pokelondon/mobile-sled/Photos/IMG_3144.jpg

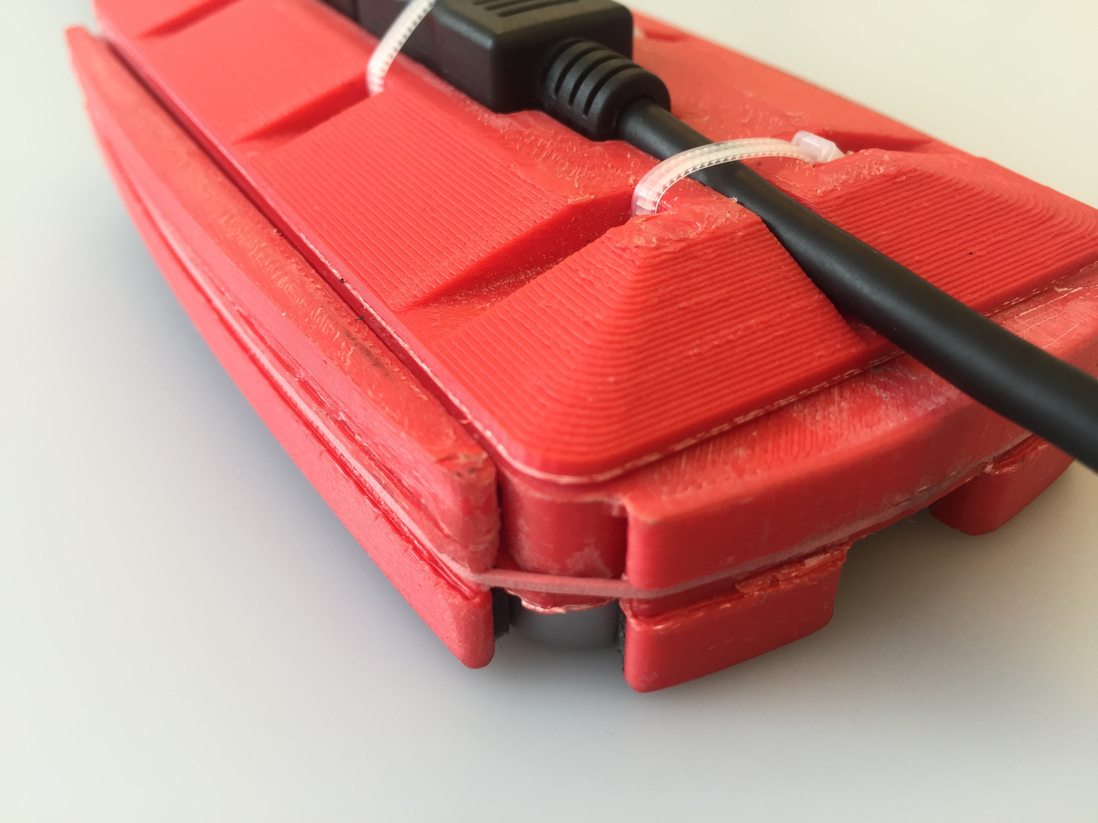
Photos/IMG_3144.jpg
