pokelondon/mobile-sled/Photos/IMG_3135.jpg

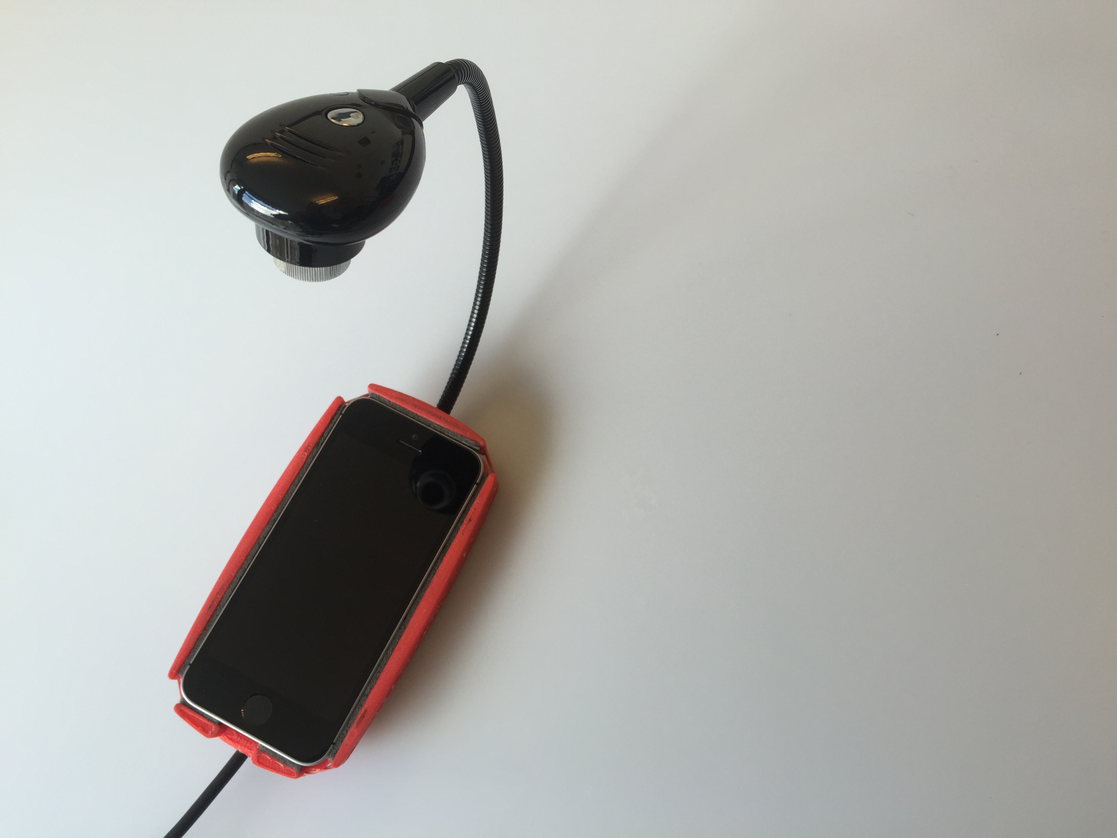
Photos/IMG_3135.jpg
