pokelondon/mobile-sled/README_A_Instructions_Parts_Software.md

# Instructions

The STL files have been separated into groups suitable for smaller 3D printing platterns. If your pattern is larger of course feel free to combine them. 

The side and end expansion leaves include extension modules that can be added to enclose the sled more elegantly. They are only really cosmetic so can be omitted if a bit fiddly.

The eyelets for the cable ties can tricky to dig out after printing. if your printer supports more than one filament and is compatible with rinse-away support material it will make life a bit easier.

We used some foam padding within the sled walls to hold the phone more securely and prevent scratching. you can use draft excluder for this although it will need cutting down to width. We managed to find some speaker foam sealing tape on Amazon that is the perfect size (see parts list below).

The rubber band sits within it’s recessed channel and holds the phone securely. When using larger phones such as the iPhone6+ (largest catered for) it is easier to remove the rubber band first. However it can then be a bit tricky putting it back on again. We found that gluing the band (just one spot) to the bottom leaf by the cable really helps with this.

The back of the sled has been designed to attach to the HUE web cam and Amazon basics extension cable specifically.

# Part list for sled

__HUE HD (black) USB camera__
to record interactions with the device
http://amzn.to/29sHoEw

__AmazonBasics USB 2.0 A-Male to A-Female Extension Cable (2 m / 6.5 Feet)__
To attach the sled to the computer
http://amzn.to/29qwtxH

__Monacor 12.2240 Speaker Foam Sealing Tape__
to pad the inside of the sled to hold the phone more securely and prevent scratching
http://amzn.to/29py1aO

__Cable ties__
to attach the webcam and USB extension cable to the sled
http://amzn.to/29gOfRQ

__LOCTITE Powerflex Ultra Control Gel Super Glue 3g__
to glue it all together (suitable for ABS 3D print filament)
http://amzn.to/29dcv8R

# Part and software list for the rest of the kit

__+1 HUE HD (black) USB camera__
to record users facial clues
http://amzn.to/29sHoEw

__+1 AmazonBasics USB 2.0 A-Male to A-Female Extension Cable (2 m / 6.5 Feet)__
To attach the camera to the computer
http://amzn.to/29qwtxH

__NEXTANY® Professional Skype Audio Sound Podcast Microphone__
To record the audio (this is what we went for but the exact mic isn’t important.
http://amzn.to/29sICzy

__AmazonBasics Apple Certified Lightning to USB Cable - 1.8 m (6 ft) - Black__
You’re going to need to power and capture the phone screen (sorry android users)
http://amzn.to/29qz22M

__Anker 4-Port Ultra-Slim USB 3.0 Data Hub with 10W Power Adapter__
You’re going to be handling a lot of data transfer and powering a lot of devices. a powered USB hub is essential
http://amzn.to/29gQbd2

__Bean Bag Cushion Holder for Smartphones__
Not essential but this will make everything sit neatly on the table for when your test subjects arrive. 
http://amzn.to/29HoSa4

__Quicktime__
to monitor the phone screen (not to record, we do this with snaggit)
https://support.apple.com/en-gb/HT201066

__Security Spy__ 
To monitor the feed from the sled camera and the user face camera (tip… you car rotate the feed from the sled camera!)
http://bit.ly/25UzLNt

__Snagit__
To screen capture all the feeds being monitored by Quicktime, Security Spy and add the audio feed from the mic
http://bit.ly/1fY6FH9

# Bonus feature

__Touchepose+__
This requires jailbreaking your iPhone which we can’t recommend but feels great if you manage it. There’s the first clue, happy hunting.

# Some tips for your testing session (apologies for iOS bias)

If using a prototype use offline mode if possible, (wifi and cellular data are by sods law unreliable)
Set phone to airplane mode
Set phone to do not disturb
Set phone orientation lock
Set phone auto-lock to off
Set phone passcode to off
Set iPhoto not to open when phone plugged in
Set iTunes not to open when phone plugged in
