pokelondon/mobile-sled/Photos/IMG_3124.jpg

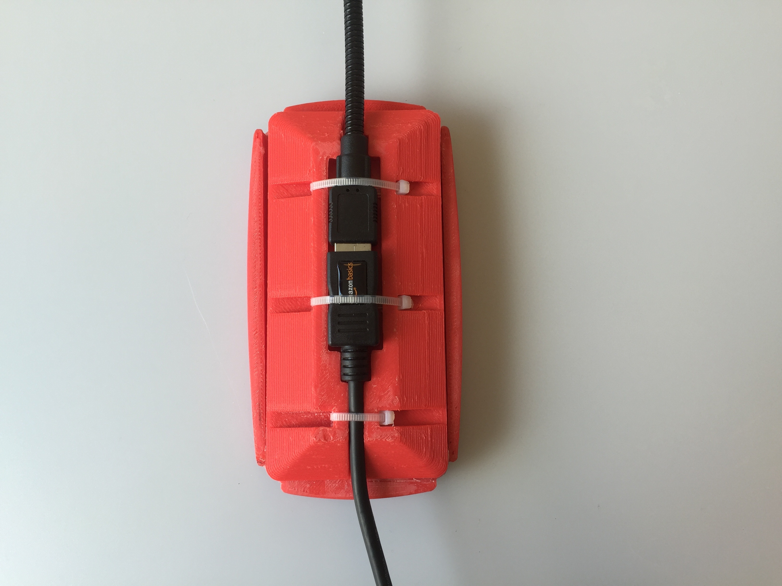
Photos/IMG_3124.jpg
