pokelondon/mobile-sled/Photos/IMG_3129.jpg

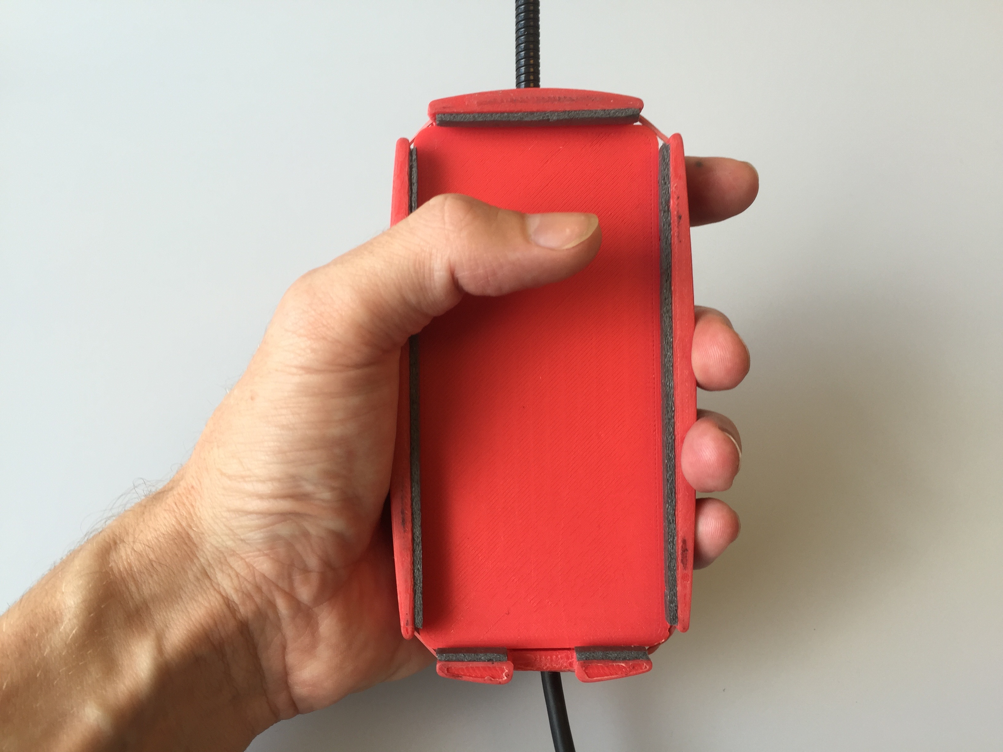
Photos/IMG_3129.jpg
