pokelondon/mobile-sled/Photos/IMG_3130.jpg

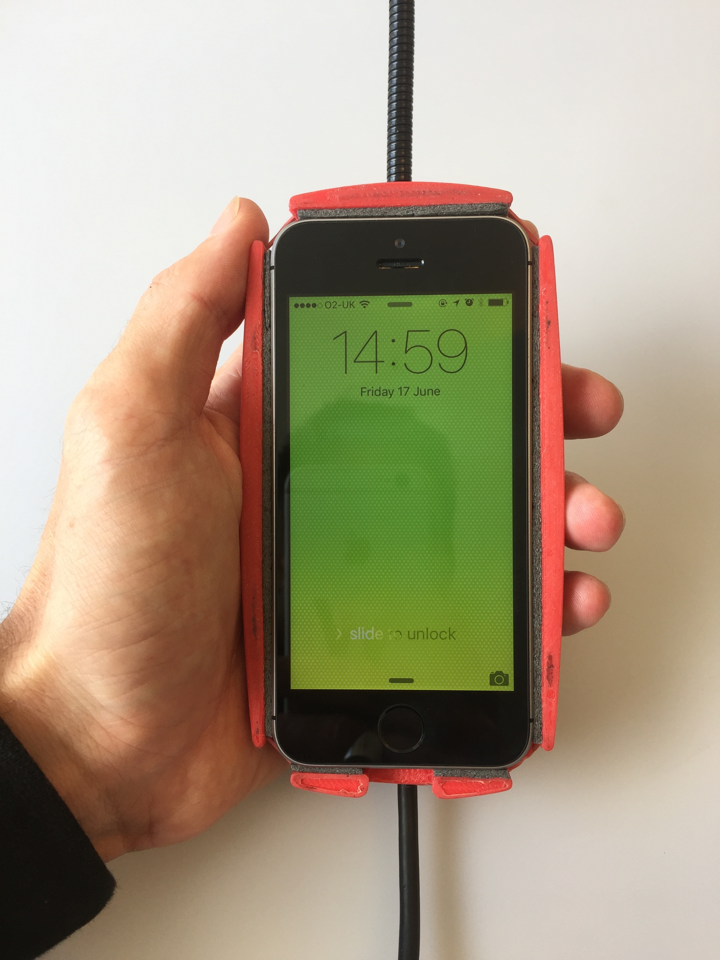
Photos/IMG_3130.jpg
