pokelondon/mobile-sled/Photos/IMG_3800.JPG

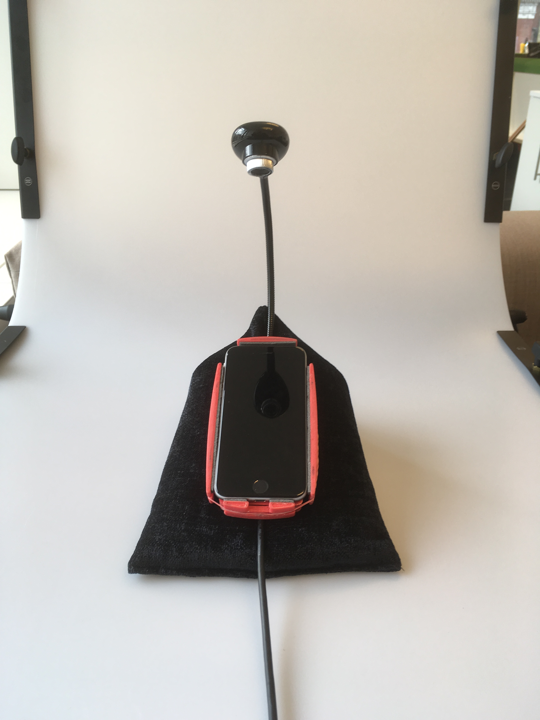
Photos/IMG_3800.JPG
