pokelondon/mobile-sled/Photos/Sled.gif

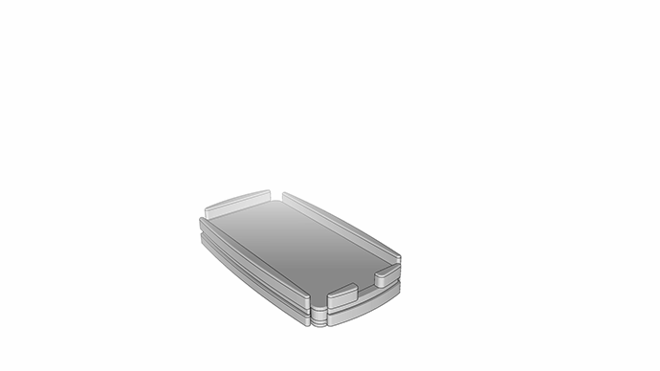
Photos/Sled.gif
