pokelondon/mobile-sled/STL_Export/Body.stl

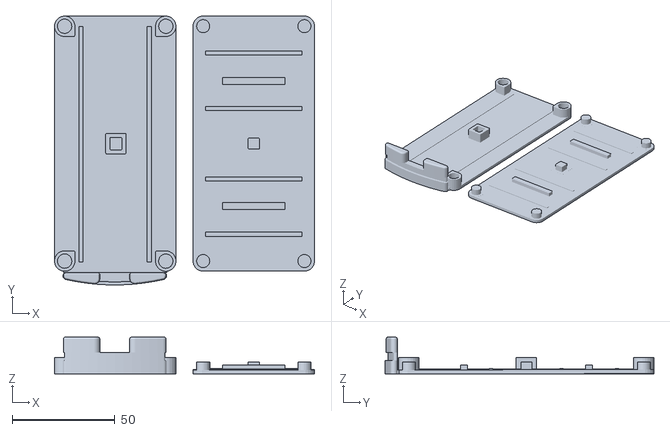
[picture p8: CAD file, 2016-07-05]
STL_Export/Body.stl
126.8 x 131.1 x 18.0
