pokelondon/mobile-sled/STL_Export/Backplate.stl

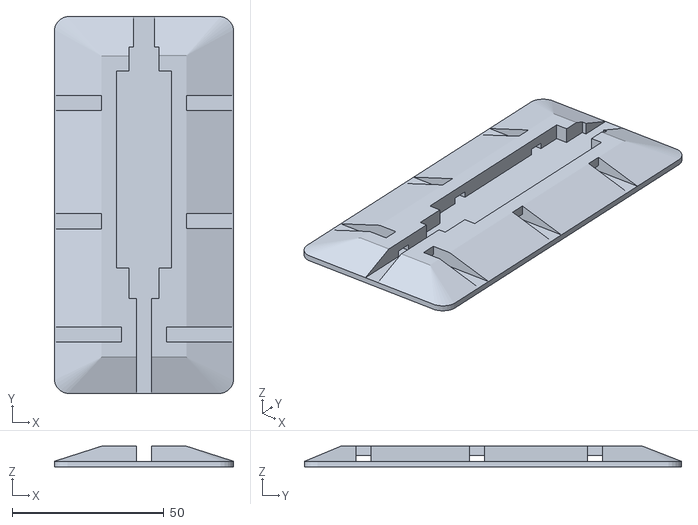
[picture p9: CAD file, 2016-07-05]
STL_Export/Backplate.stl
59.2 x 124.4 x 6.82
