pokelondon/mobile-sled/STL_Export/TopLeaf.stl

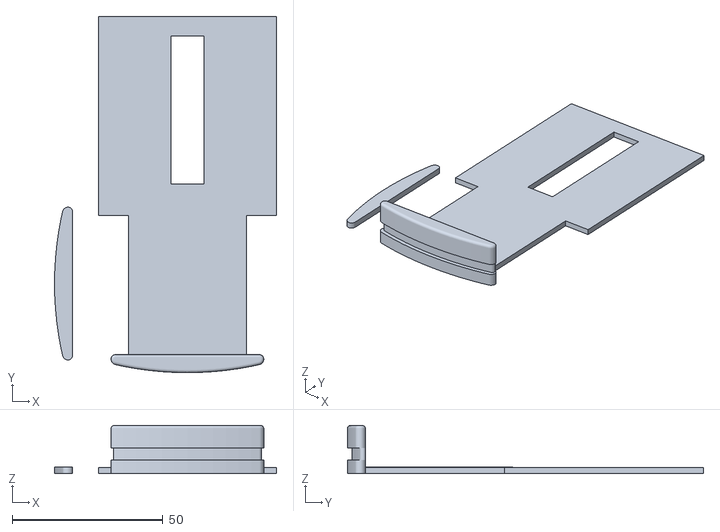
[picture p10: CAD file, 2016-07-05]
STL_Export/TopLeaf.stl
73.5 x 118.0 x 15.9
