pokelondon/mobile-sled/STL_Export/SideLeaves.stl

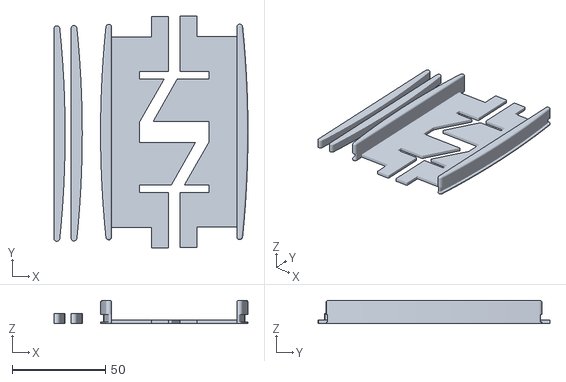
[picture p11: CAD file, 2016-07-05]
STL_Export/SideLeaves.stl
104.2 x 124.5 x 12.5
