pokelondon/mobile-sled/(list of files, cad)

Other CAD files:
Sketchup/Constructed_POKE_Testing_Sled_160704.skp
Sketchup/Parts_POKE_Testing_Sled_160704.skp
